laristizabal1/uPMU/uPMU_AFE/docs/uPMU_AFE_hoja2_mcu_gps.pdf

# uPMU prototipo Hoja 2/2: MCU, sincronización GPS y selector de país

NUCLEO-F303K8 (STM32F303K8T6, Cortex-M4F, 72 MHz) · GPS con PPS · los nombres de red (ADC_V, ADC_I, +3V3A) vienen de la hoja 1

## NUCLEO-F303K8

### STM32F303K8T6

TIM2 (32 bit, 72 MHz)
ARR = 1199 TRGO a 60 kHz
ADC1 + ADC2 simultáneos
DMA circular

TIM2_CH2: captura del PPS
(mismo contador que el ADC)

## PA0 / A0 (ADC1_IN1)

## ADC_V

## PA4 / A3 (ADC2_IN1)

## ADC_I

+3V3A

3V3

## GND

VDDA = 3V3 del Nucleo
(verificar filtrado en UM1956)

## Módulo GPS

NEO-6M / NEO-M8N
(GY-GPS6MV2)

ANT (SMA, antena activa
a la ventana)
PA1 / A1 (TIM2_CH2) | PPS

## PPS

PA10 / D0 (USART1_RX) | TX

## GPS_TX (NMEA)

PA9 / D1 (USART1_TX) | RX

## GPS_RX

3V3 | VCC
GND | GND

## +3V3 (GPS)

## GND

## PB0 / D3

SW3 50/60 Hz
abierto = 60 Hz (CO)
cerrado a GND = 50 Hz (CL) (pull-up interno)

## PB3 / D13

R_L 470

LD3 (en placa) | LED de estado (PPS válido)

## USB micro (ST-LINK VCP)

USART2 · PA2 / PA15

PC / ESP32-S3: tramas de fasores

## Plan de temporización (confirmar en RM0316)

- Reloj: HSE 8 MHz del MCO del ST-LINK PLL 72 MHz (el Nucleo-32 no trae cristal).
- Fs = 60 kS/s en 50 y 60 Hz ventana de 4 ciclos: 4000 muestras (60 Hz) o 4800 (50 Hz).
- Tiempo de muestreo del ADC 7,5 ciclos (Rs = 1 k ).

## Cadena de procesamiento (simulada, hoja 1 + este MCU)

1. Captura del PPS mide fase muestra-PPS y periodo real (corrige deriva del cristal).
2. CIC3, R = 4: 60 15 kS/s (retardo 4,5 muestras fijo).
3. IpDFT con ventana Hann + ajuste sinusoidal (Gauss-Newton) sobre 4 ciclos f, módulo y ángulo.
4. Compensa RC y CIC con el modelo; calibración de
1 punto por canal con carga resistiva.
5. Sin PPS: bandera «no sincronizado» (nunca válido).
