laristizabal1/uPMU/uPMU_AFE/docs/uPMU_AFE_hoja3_modelo_ltspice.pdf

## uPMU prototipo Hoja 3/3: el circuito que simula LTspice

Mismo circuito que los netlists de netlists/*.cir · valores = codigo/params.py · los elementos en gris son del MODELO: no se compran ni se sueldan

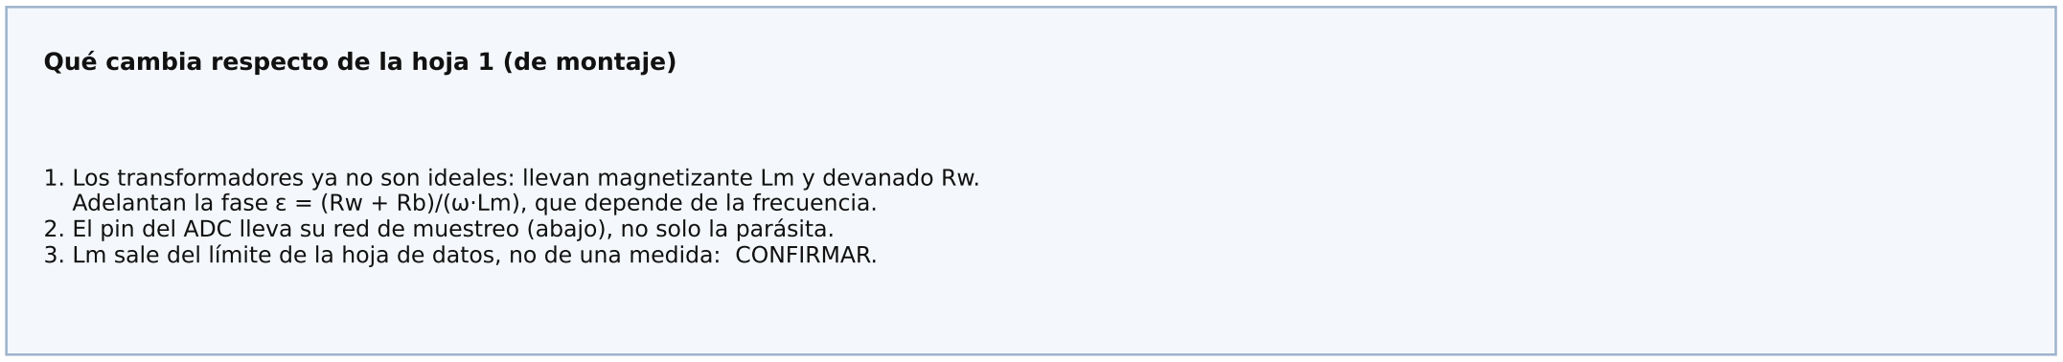
[picture p2: figure]

Qué cambia respecto de la hoja 1 (de montaje)

1. Los transformadores ya no son ideales: llevan magnetizante Lm y devanado Rw. Adelantan la fase = (Rw + Rb)/( ·Lm), que depende de la frecuencia.
2. El pin del ADC lleva su red de muestreo (abajo), no solo la parásita.
3. Lm sale del límite de la hoja de datos, no de una medida: CONFIRMAR.

Consecuencia medida en la simulación

Con el transformador ideal la fase V I daba 0,0000° exactos.
Con el modelo real: | 0.1733° a 50 Hz y | 0.1444° a 60 Hz.
La calibración de un punto la quita en f0, pero no fuera de f0:
a f0 ± 5 Hz el TVE pasa de ~0,01 % a 0,15 0,27 % (límite de la norma: 1 %).

Modelo del transformador

= (Rw + Rb) / ( ·Lm) [adelanto]

Lm NO se inventó: se derivó del error de fase de la hoja de datos.
ZMPT101B: | 20 con 100 | de carga
(aquí la carga es 470 | = 4,7×).
SCT-013: la hoja no lo publica;
se mantiene el supuesto de 1°.
50 Hz | 60 Hz
_V +0.827° | +0.689°
_I +1.000° | +0.833°
RC | -0.679° | -0.814°

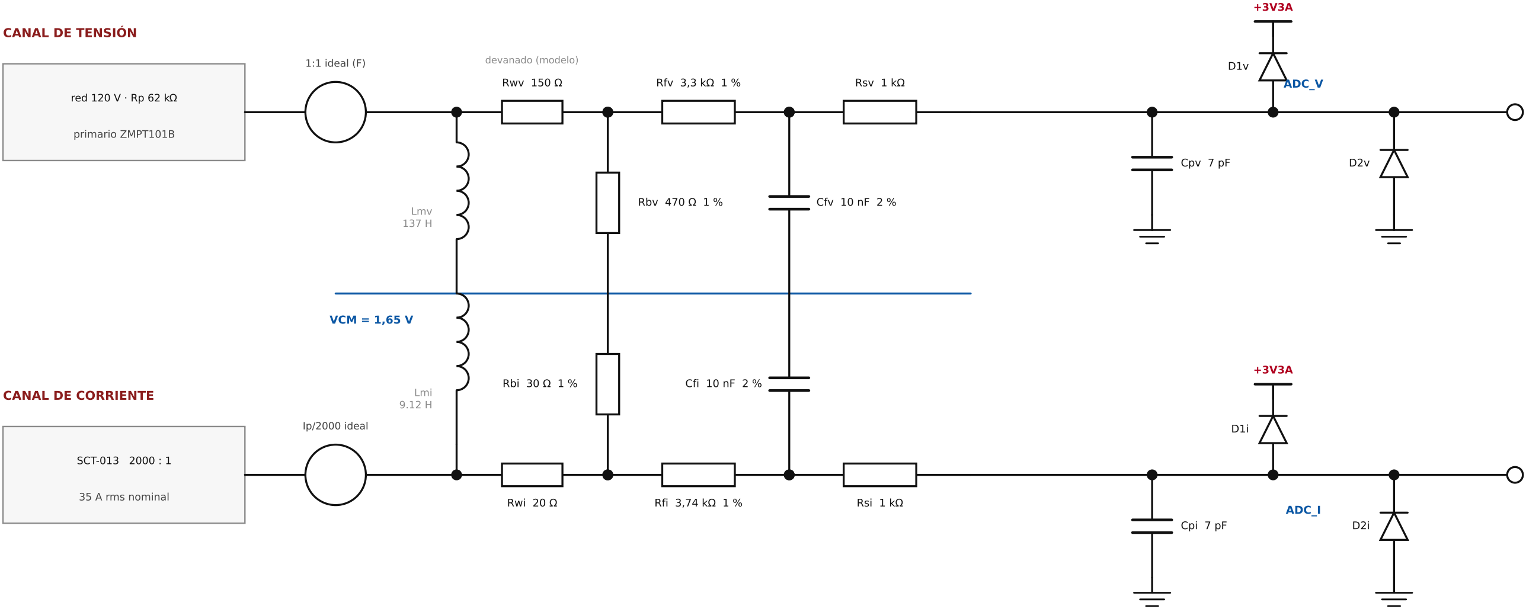
[picture p3: figure]
VCM = 1,65 V; CANAL DE TENSIÓN; red 120 V · Rp 62 k; primario ZMPT101B; 1:1 ideal (F); Lmv 137 H; Rwv 150; devanado (modelo); Rbv 470; Rfv 3,3 k; Cfv 10 nF 2 %; Rsv 1 k; ADC_V; Cpv 7 pF; CANAL DE CORRIENTE; SCT-013 2000 : 1; 35 A rms nominal; Ip/2000 ideal; Lmi 9.12 H; Rwi 20; Rbi 30; Rfi 3,74 k; Cfi 10 nF 2 %; Rsi 1 k; ADC_I; Cpi 7 pF

RED DE MUESTREO DEL ADC (modelo; está dentro del STM32F303K8)

pin ADC

C_par 7 pF
(pad + PCB)

muestreo: 4.10 µs
(61,5 ciclos a 15 MHz)

R_ADC 1 k CONFIRMAR

C_SH 5 pF
CONFIRMAR

¿Asientan 12 bits en la ventana de muestreo? Sí, con 46× de margen

= (Rsv + R_ADC) · C_SH = (1 k + 1 k ) · 5 pF = 10.0 ns
12 bits piden ln(2¹³)· = 90 ns; la ventana dura 4.10 µs margen 46×

Simulado con el interruptor real (netlists/uPMU_AFE_adcsh.cir), 60 ventanas: error entre C_SH y el pin al cerrar = 0.0028 LSB (canal V), 0.0017 LSB (canal I).

Ayuda que Cfv = 10 nF sea 2000× el condensador de muestreo: la carga que se redistribuye vale 5 pF / 10 nF = 5·10 de la diferencia entre muestras.

Hoja de simulación, no de montaje: Lm, Rw, R_ADC y C_SH son elementos del modelo. Para armar, usar la hoja 1/3. Los puntos CONFIRMAR están en docs/RESULTADOS_LTspice.pdf.
