laristizabal1/uPMU/STM32/uPMU/docs/nmea_delay.png

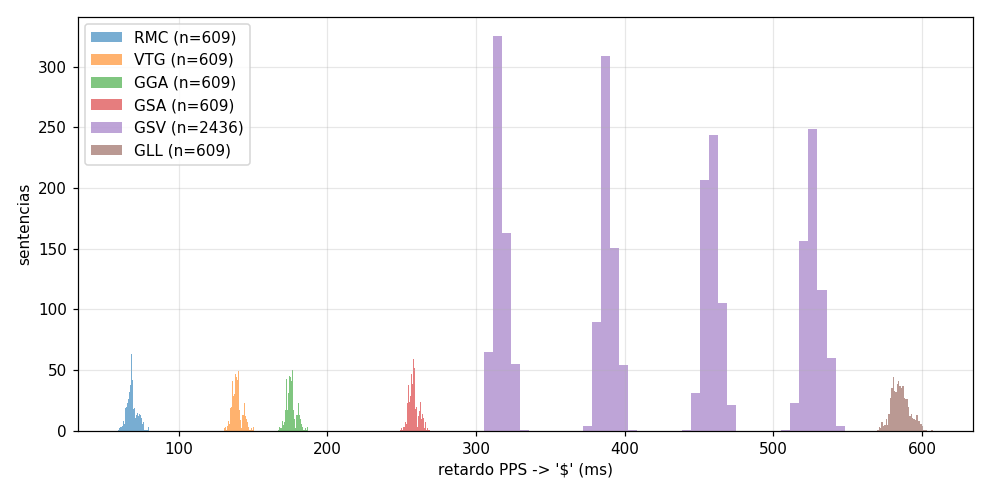
STM32/uPMU/docs/nmea_delay.png
