laristizabal1/uPMU/STM32/uPMU/docs/pps_6min.png

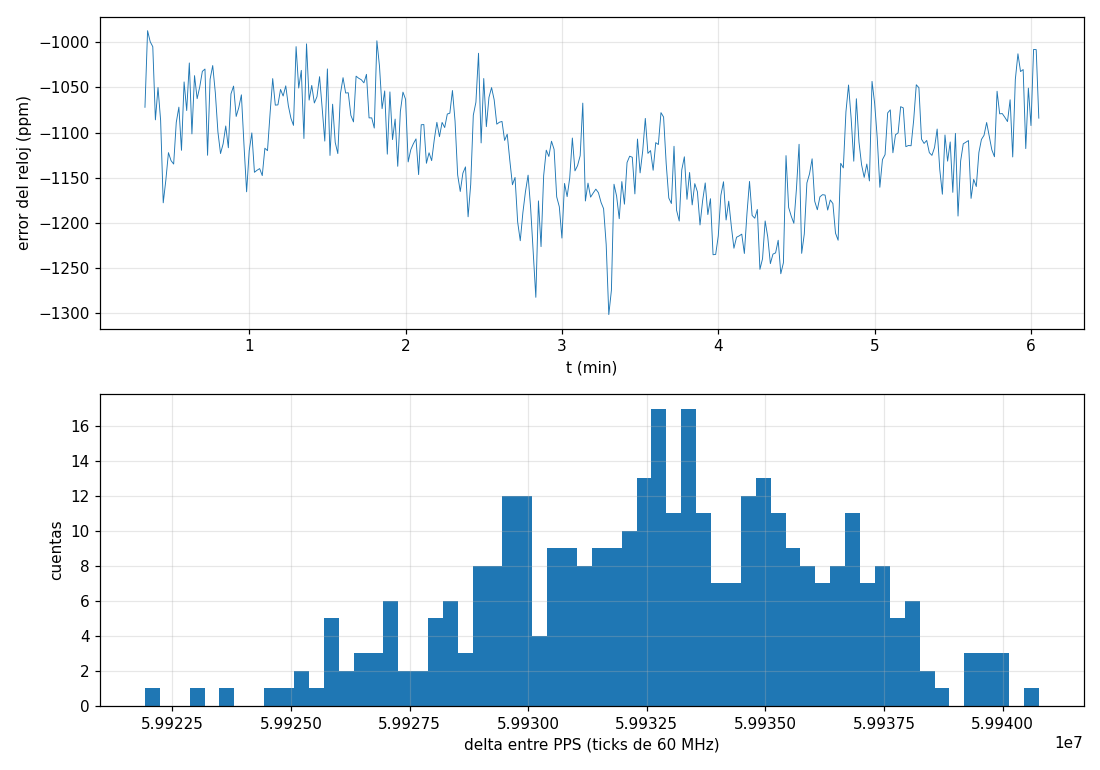
STM32/uPMU/docs/pps_6min.png
