laristizabal1/uPMU/STM32/uPMU/docs/pps_30min.png

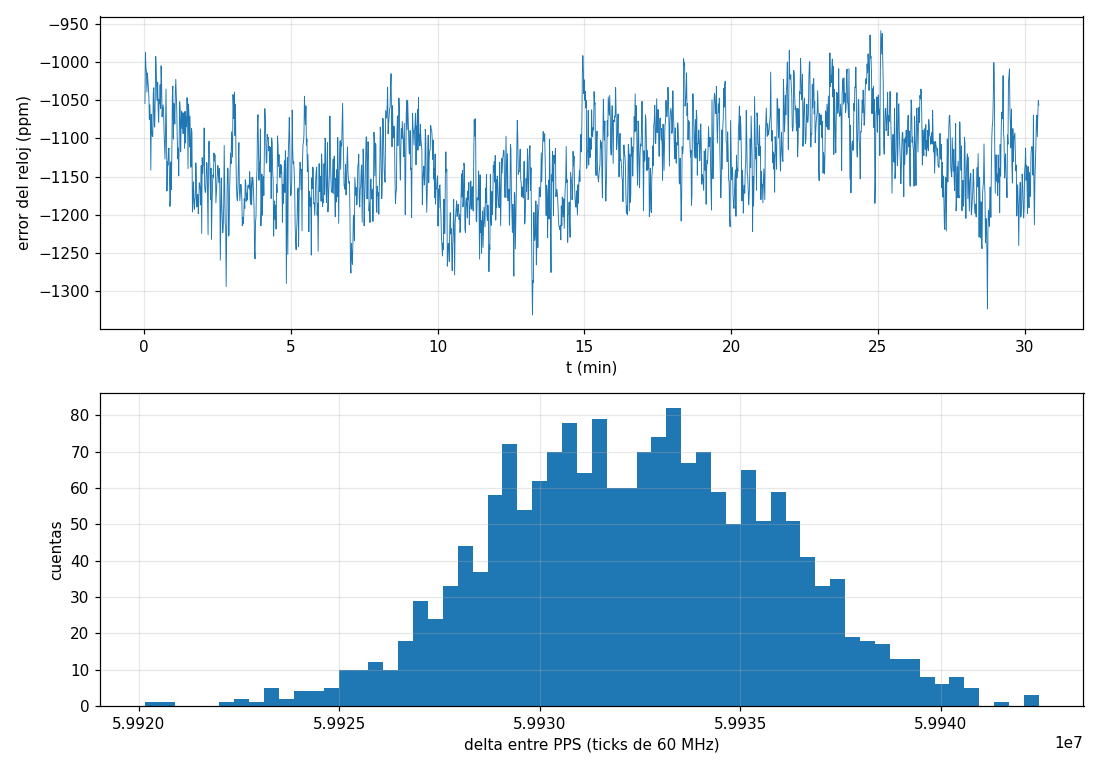
STM32/uPMU/docs/pps_30min.png
