laristizabal1/uPMU/STM32/uPMU/docs/stamp.png

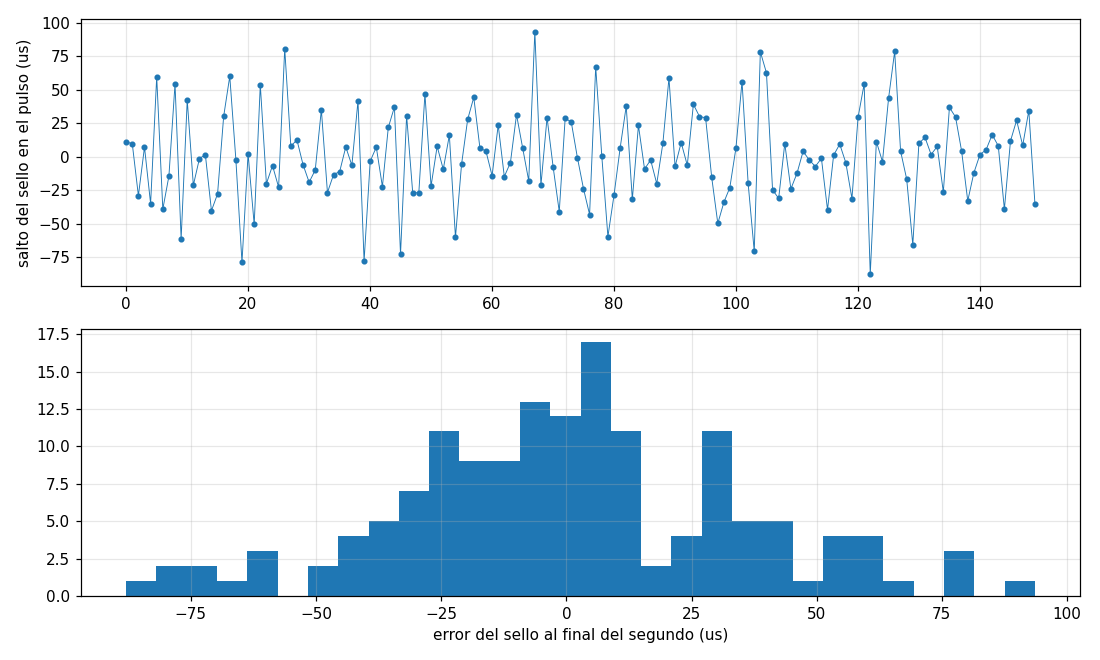
STM32/uPMU/docs/stamp.png
