laristizabal1/uPMU/STM32/uPMU/docs/viewer_5min.png

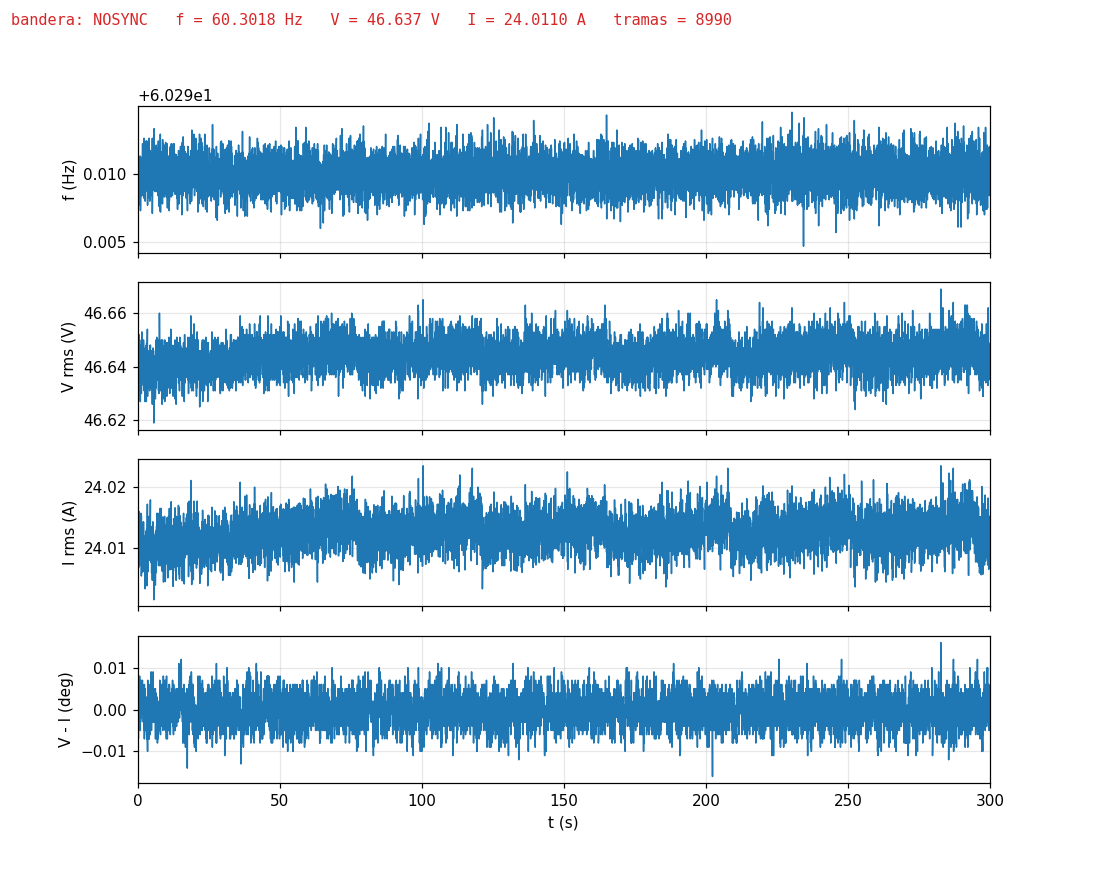
STM32/uPMU/docs/viewer_5min.png
