laristizabal1/uPMU/STM32/uPMU/docs/viewer_replay.png

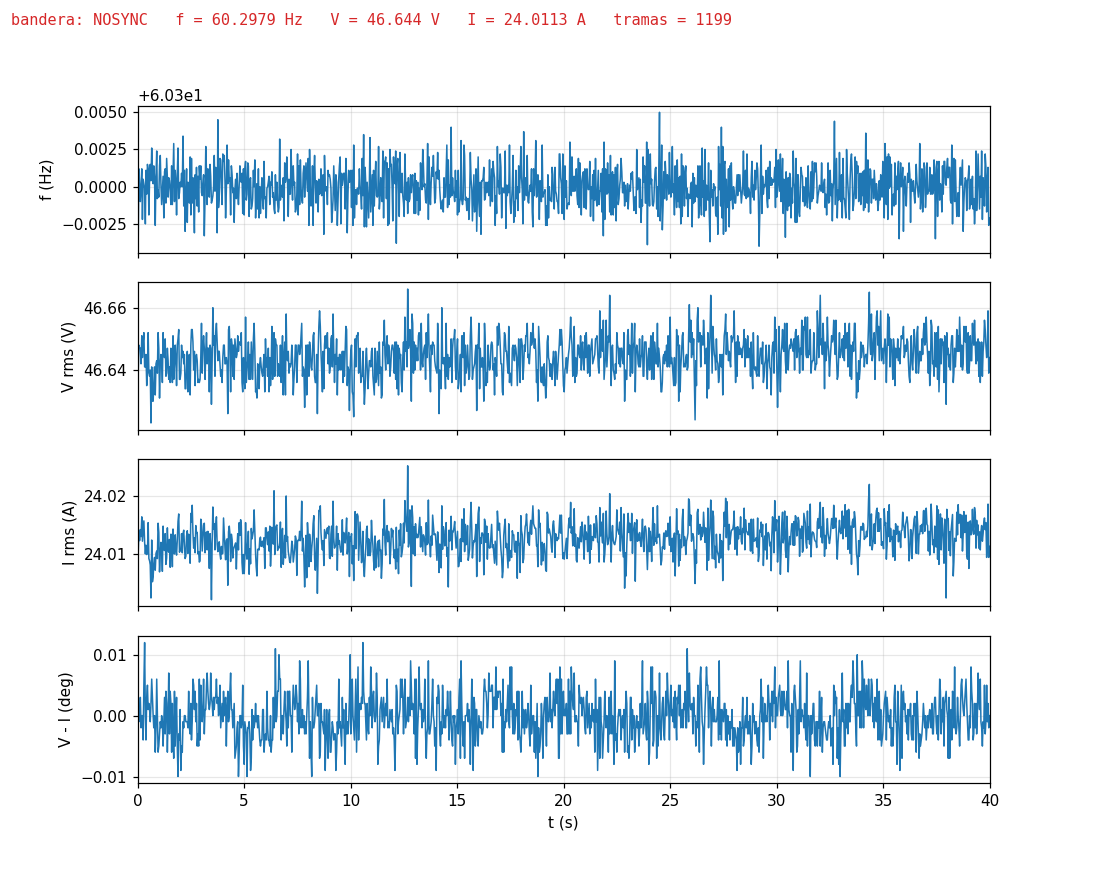
STM32/uPMU/docs/viewer_replay.png
