laristizabal1/uPMU/uPMU_AFE/figuras/ltspice_ac.png

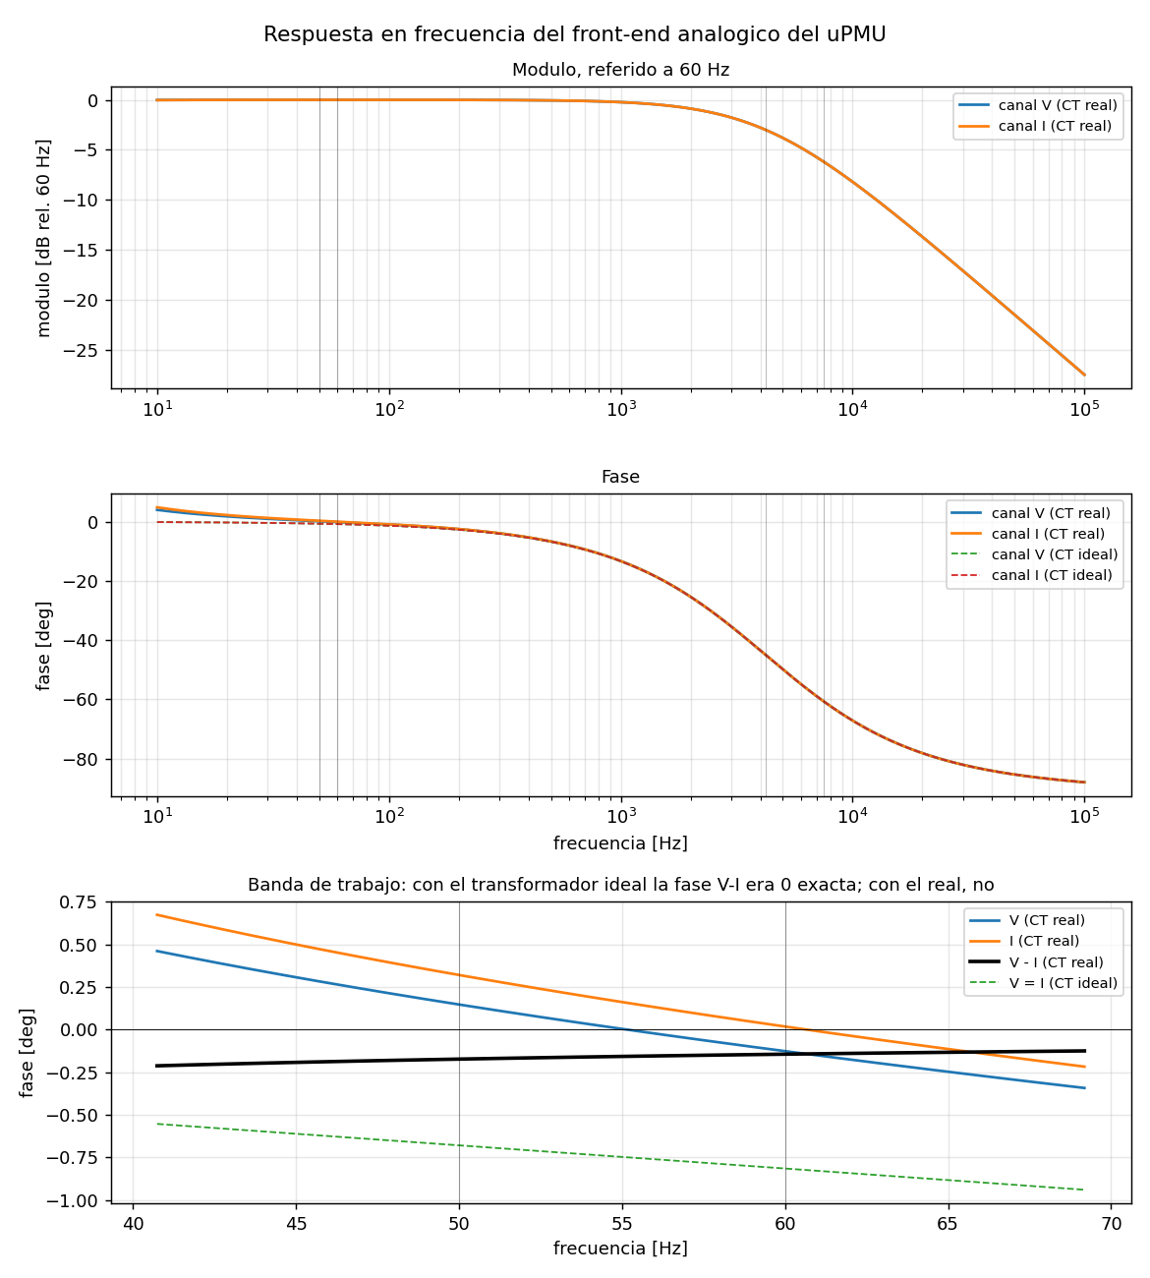
uPMU_AFE/figuras/ltspice_ac.png
