laristizabal1/uPMU/uPMU_AFE/figuras/ltspice_montecarlo.png

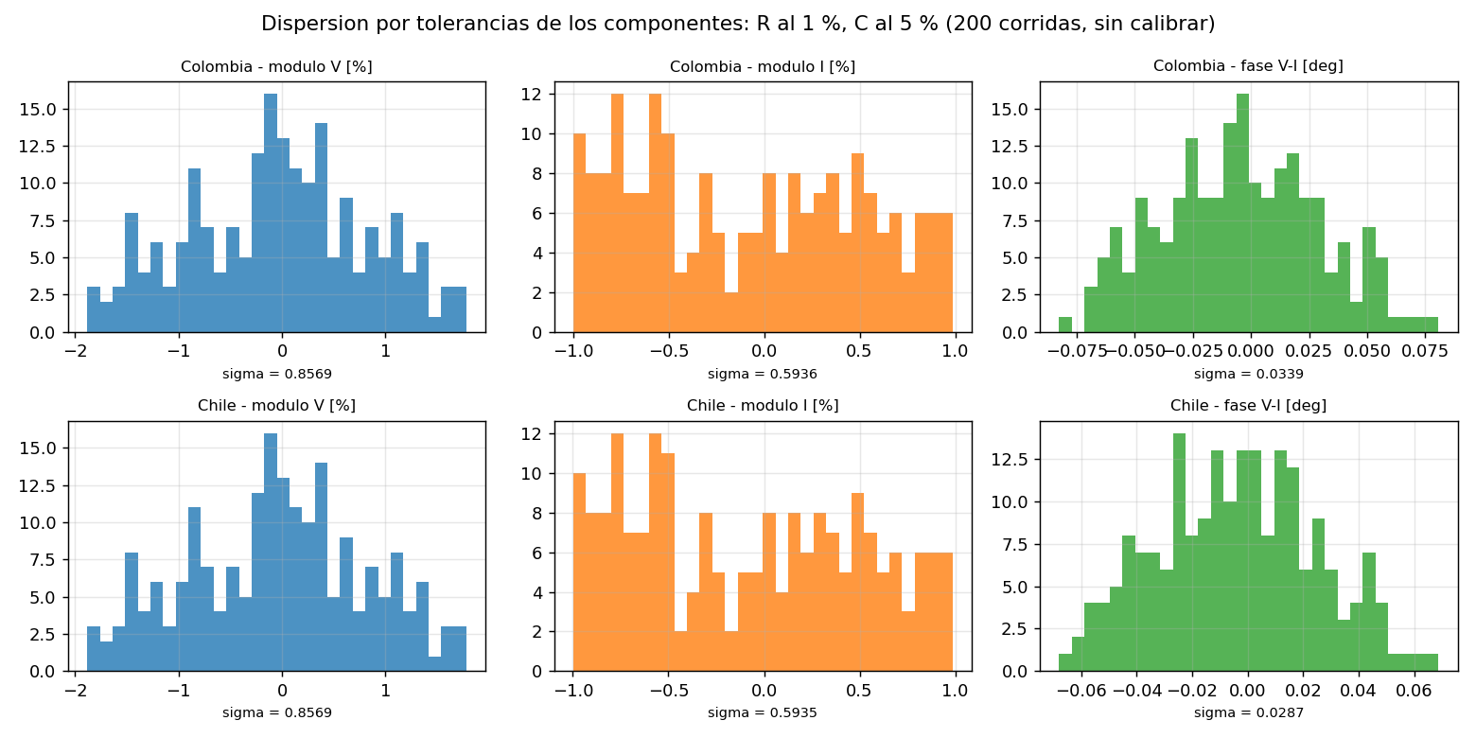
uPMU_AFE/figuras/ltspice_montecarlo.png
