laristizabal1/uPMU/uPMU_AFE/figuras/ltspice_tran.png

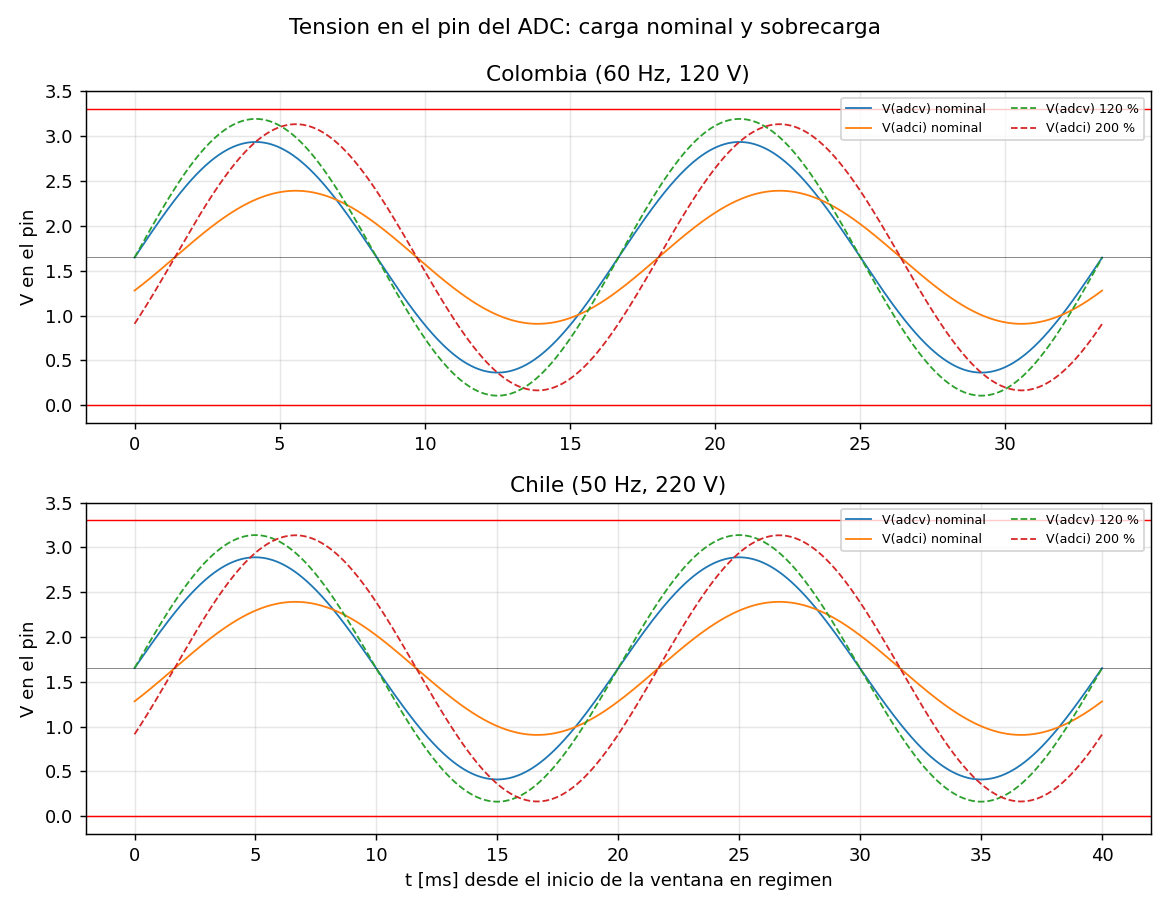
uPMU_AFE/figuras/ltspice_tran.png
