laristizabal1/uPMU/uPMU_AFE/figuras/uPMU_AFE_hoja1_analogico.png

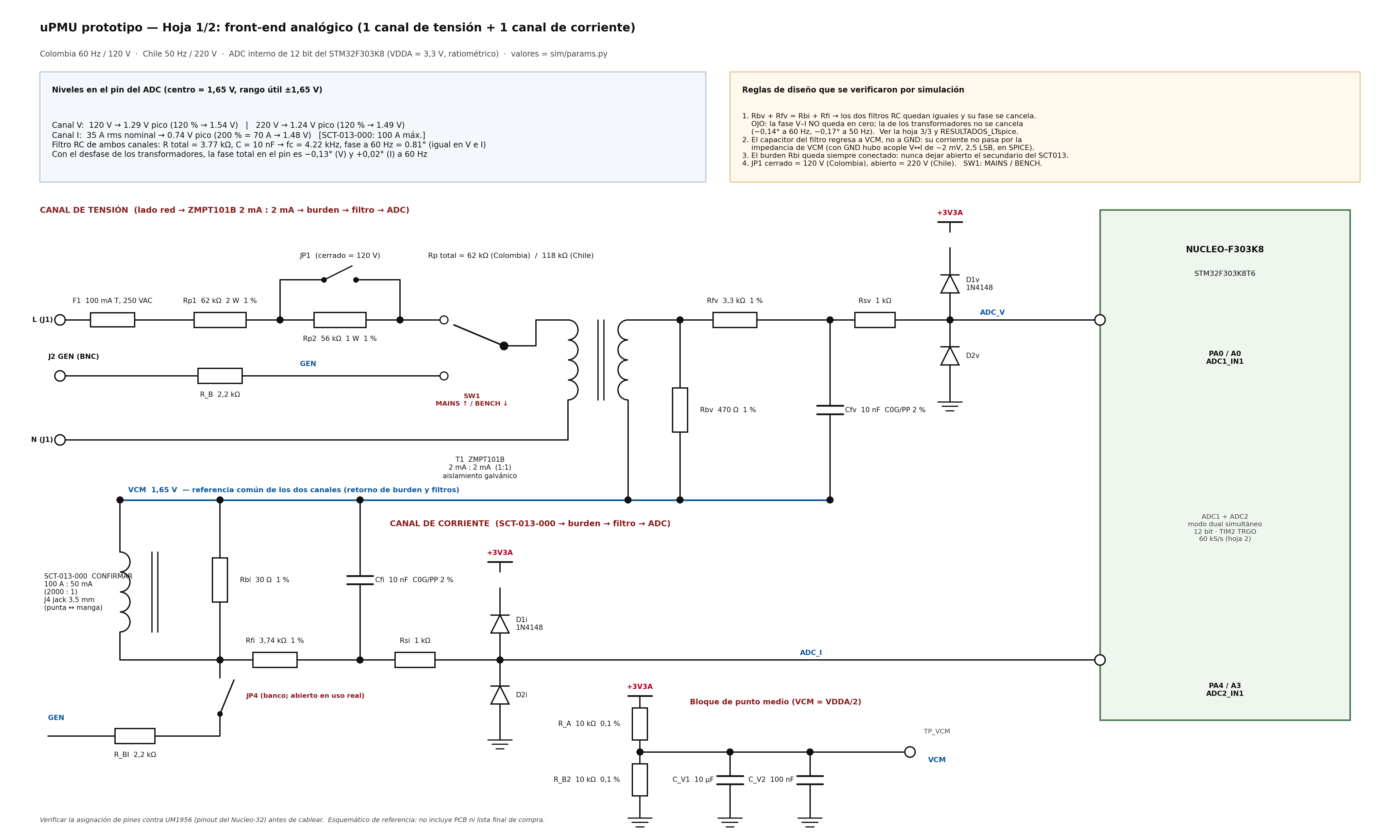
uPMU_AFE/figuras/uPMU_AFE_hoja1_analogico.png
