laristizabal1/uPMU/uPMU_AFE/figuras/uPMU_AFE_hoja2_mcu_gps.png

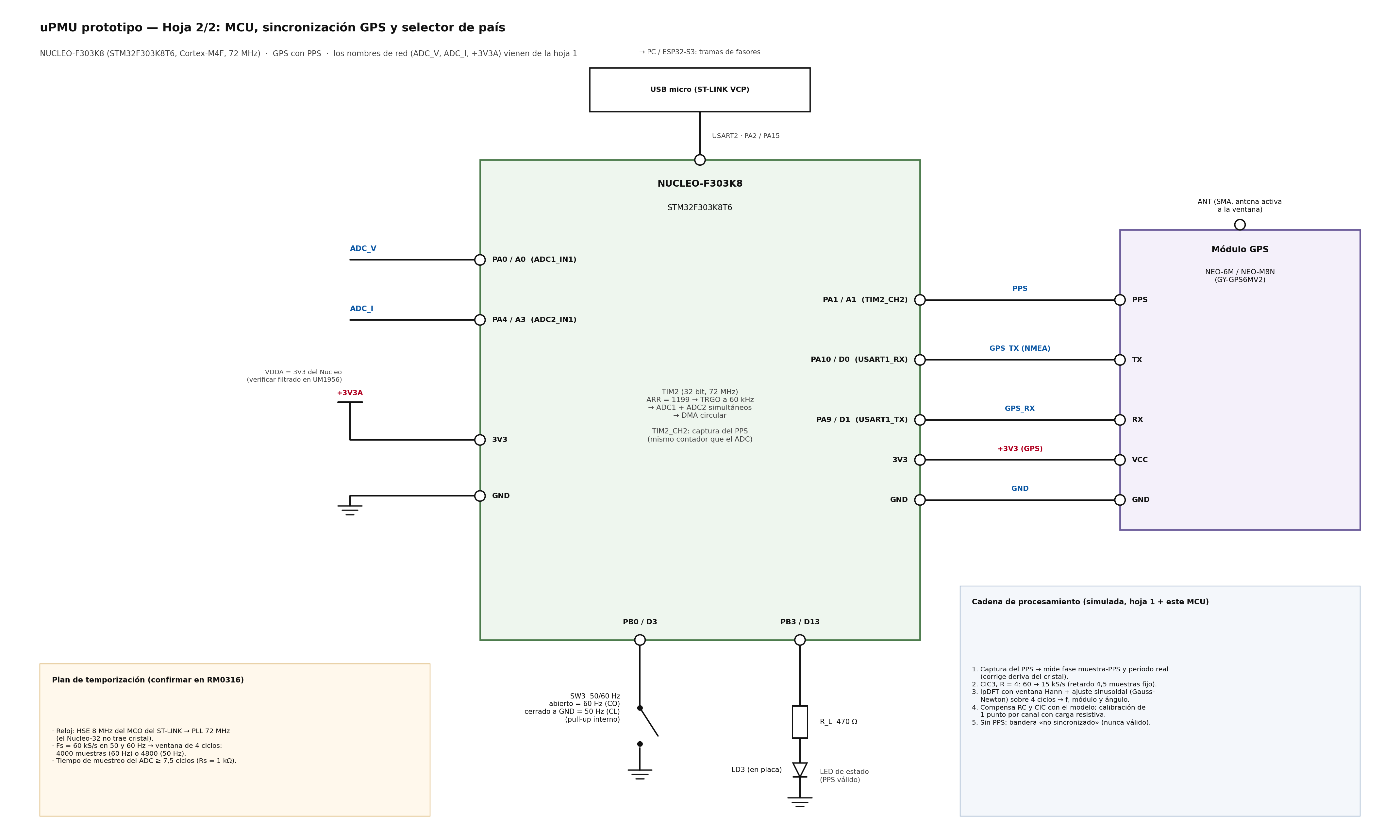
uPMU_AFE/figuras/uPMU_AFE_hoja2_mcu_gps.png
