laristizabal1/uPMU/uPMU_AFE/figuras/uPMU_AFE_hoja3_modelo_ltspice.png

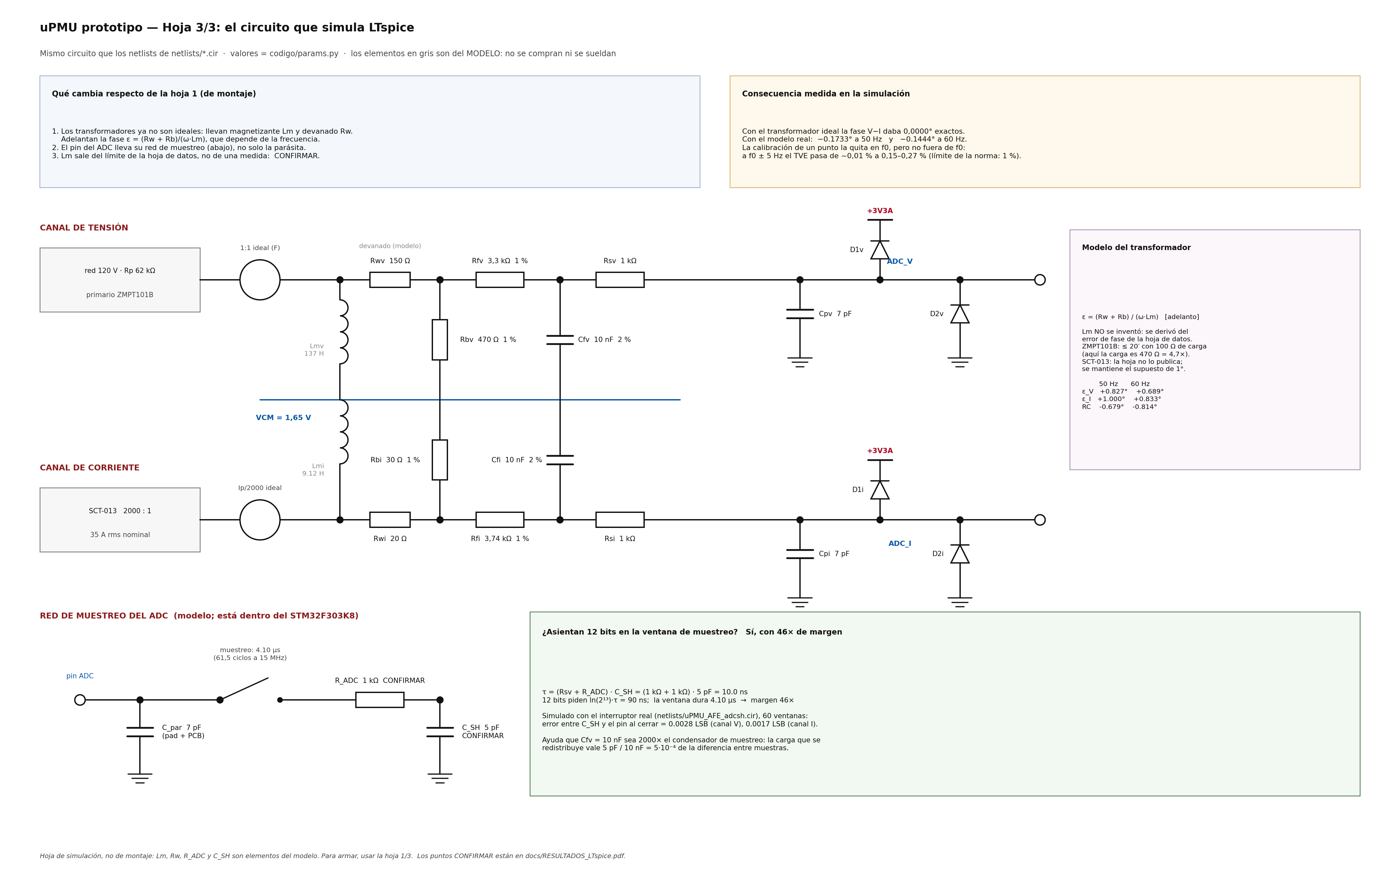
uPMU_AFE/figuras/uPMU_AFE_hoja3_modelo_ltspice.png
