laristizabal1/uPMU/STM32/uPMU/data/t5_dac_test_20261011.csv

2026-10-11T02:58:23.184208 | PMU,,73.9155,0.006,-125.182,0.0055,-62.340,NOSYNC
2026-10-11T02:58:23.193225 | PMU,,50.4883,0PMU,,60.2408,2.829,136.172,24.0120,115.209,NOSYNC
2026-10-11T02:58:23.223190 | PMU,,60.0486,2.838,137.974,24.0068,118.803,NOSYNC
2026-10-11T02:58:23.258274 | PMU,,60.0945,2.784,138.377,24.0126,122.415,NOSYNC
2026-10-11T02:58:23.291560 | PMU,,60.2215,2.796,139.538,24.0112,126.003,NOSYNC
2026-10-11T02:58:23.326184 | PMU,,60.1505,2.838,139.987,24.0116,129.602,NOSYNC
2026-10-11T02:58:23.359892 | PMU,,60.1941,2.806,142.847,24.0069,133.215,NOSYNC
2026-10-11T02:58:23.394235 | PMU,,60.0476,2.823,144.168,24.0136,136.812,NOSYNC
2026-10-11T02:58:23.424353 | PMU,,60.1162,2.845,144.838,24.0108,140.405,NOSYNC
2026-10-11T02:58:23.458186 | PMU,,60.2395,2.823,145.838,24.0096,144.009,NOSYNC
2026-10-11T02:58:23.492286 | PMU,,60.2259,2.806,147.784,24.0110,147.608,NOSYNC
2026-10-11T02:58:23.526912 | PMU,,60.0417,2.811,149.021,24.0086,151.202,NOSYNC
2026-10-11T02:58:23.561254 | PMU,,60.1873,2.791,149.543,24.0117,154.808,NOSYNC
2026-10-11T02:58:23.590711 | PMU,,60.0625,2.850,150.882,24.0078,158.415,NOSYNC
2026-10-11T02:58:23.625254 | PMU,,60.2211,2.785,152.787,24.0082,162.011,NOSYNC
2026-10-11T02:58:23.659463 | PMU,,60.1991,2.829,155.048,24.0106,165.608,NOSYNC
2026-10-11T02:58:23.693131 | PMU,,60.1065,2.790,155.034,24.0085,169.205,NOSYNC
2026-10-11T02:58:23.700969 | ADC,2,179968,60160,0,0,0,148.4/34/237/36.53,2047.8/1411/2686/446.88
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
2026-10-11T02:58:53.123983 | PMU,,60.0407,2.334,165.491,24.0136,104.388,NOSYNC
2026-10-11T02:58:53.158127 | PMU,,60.1354,2.363,166.528,24.0108,107.991,NOSYNC
2026-10-11T02:58:53.160127 | STATE,111026T075853.00,0,0
2026-10-11T02:58:53.191928 | PMU,,60.1641,2.362,168.614,24.0146,111.590,NOSYNC
