laristizabal1/uPMU/uPMU_AFE/netlists/uPMU_AFE.asc

Cfi: cap; 1e-08
Cfv: cap; 1e-08
Cpi: cap; 7e-12
Cpv: cap; 7e-12
Cvcm1: cap; 1e-05
Cvcm2: cap; 1e-07
D1i: diode; D1N4148
D1v: diode; D1N4148
D2i: diode; D1N4148
D2v: diode; D1N4148
Fv: f; Vsp 1
Ict: current; SIN(0 0.0247487 60 0 0 -30); AC 0.0175
Lmi: ind; 9.11891
Lmv: ind; 136.784
Rbi: res; 30
Rbv: res; 470
Rfi: res; 3740
Rfv: res; 3300
Rp: res; 62000
Rsi: res; 1000
Rsv: res; 1000
Rvcm1: res; 10000
Rvcm2: res; 10000
Rwi: res; 20
Rwv: res; 150
Vdda: voltage; 3.3
Vmains: voltage; SIN(0 169.706 60 0 0 0); AC 120
Vsp: voltage; 0
Named nets: 0, nL, np, vcm, nsv, bv, nv, adcv, vdda, nsi, bi, ni, adci
.model D1N4148 D(Is=4.352n N=1.906 Rs=.6458 Ikf=44.17m Xti=3 Eg=1.11 Cjo=4p M=.3333 Vj=.5 Fc=.5 Isr=1.21n Nr=2 Bv=110 Ibv=1u Tt=11.54n)
.options reltol=1e-6 vntol=1e-9 abstol=1e-12
.tran 2u 5.1 5 2u
uPMU AFE - Colombia (60 Hz). Generado por codigo/make_asc.py desde params.py.
OJO: el .tran simula 5 s y guarda los ultimos 100 ms. El magnetizante de los transformadores tarda segundos en asentarse (ver docs/RESULTADOS_LTspice.pdf).
