laristizabal1/uPMU/(commit log)

2026-10-12 Reorganiza el repositorio: proyecto PlatformIO en STM32/uPMU y .gitignore raiz
    El esqueleto de PlatformIO pasa de la raiz a STM32/uPMU para convivir con
    uPMU_AFE (front-end y simulacion). El .gitignore raiz deja fuera node_modules,
    las salidas regenerables de LTspice/ngspice y los PDF de terceros (Paper/).
2026-10-12 Firmware: reloj, GPS, ADC dual, CIC, estimador y cadena en vivo
    NUCLEO-F303K8. Reloj HSI/2 x PLL15 = 60 MHz (HSE opcional con -DUSE_HSE y respaldo a HSI), USART1 con NMEA y parser, TIM2 a 60 kS/s disparando ADC1+ADC2 en modo dual con DMA, captura del PPS en TIM2_CH2 con contador de disparos por hardware (TIM3), CIC de orden 3 R=4 entero, IpDFT + minimos cuadrados con FPU, ventana circular, sello UTC, maquina de estados SYNC/HOLD/NOSYNC y trama PMU. fpu.py agrega las banderas de FPU al enlazado.
2026-10-12 Herramientas y pruebas en la PC
    Registro serie, envio de vectores de prueba, generacion de vectores desde ref/, analisis del PPS y del retardo NMEA, comprobacion del sello, verificacion de TVE del firmware contra la simulacion, visor en vivo y pruebas del mismo C del firmware compilado en la PC (parser NMEA, receptor de vectores, estimador, pipeline).
2026-10-12 ref: copia de solo lectura de la simulacion de referencia (uPMU_AFE/sim)
    Parametros y cadena completa (red, sensor, burden, filtro, ADC, CIC, IpDFT + minimos cuadrados) usada como verdad para los vectores de prueba.
2026-10-12 Datos: vectores de prueba y logs crudos de medicion
    data/vectors: 14 vectores (2 redes x 7 escenarios) con codigos del ADC y salida esperada. Resto: logs con marca de tiempo de la PC de cada tarea (reloj, GPS, PPS, ADC, ruido, estimador, sello).
    [t1_2_clk_20261010.csv, t1_2_hse_probe_20261010.csv, t1_3_gps_boot_20261010.csv, t1_3_gps_nmea_20261010.csv, t1_4_state_20261010.csv, t1_5_antena2_20261011.csv, t1_5_antena_20261011.csv, t1_5_fix_20261010.csv]
2026-10-12 Docs: resultados medidos y formato de la trama
    RESULTADOS.md con las cifras de cada tarea (fecha, log, condiciones) y FORMATO_TRAMA.md con la especificacion de la linea PMU, banderas y cadencia.
2026-10-12 uPMU_AFE: front-end analogico, esquematicos y simulacion
    Esquematicos (hoja analogica y MCU+GPS), netlists SPICE/LTspice, modelo y simulacion de la cadena completa, resultados y README. Se excluyen las salidas regenerables (.raw, .db, ng_*/out_*.json) y node_modules.
2026-10-12 README raiz y .gitattributes
    Descripcion del proyecto, estructura del repositorio, estado medido, limitacion abierta del reloj y uso rapido. .gitattributes normaliza los finales de linea a LF.
2026-10-12 uPMU_AFE: simulacion en LTspice, modelo del transformador y reorganizacion
    Simulacion
    - Se corre todo en LTspice 26.0.2 en modo batch (-b). Se retira el camino
    alterno por ngspice, que era el plan B mientras no hubiera LTspice.
    - Contraste independiente con un modelo cerrado exacto en Python
    (codigo/afe_model.py): coinciden a 0,0003 % en modulo y 0,0005 grados en
    fase a 50/60 Hz, y a 0,016 mV (0,020 LSB) muestra a muestra en el
    transitorio.
    Correcciones de modelado
    - .ac excitaba los dos canales a la vez y con AC 1 = 1 A en el secundario
    del CT (2000 A primarios): contaminaba el canal V un 0,39 % en modulo.
    Ahora cada canal se excita por separado y con su unidad fisica.
    - Los tr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
2026-10-12 README: diagrama de bloques de la cadena de medicion
    Reemplaza el esquema en texto plano por una figura generada desde
    codigo/params.py (codigo/draw_cadena.py), con la convencion habitual de
    un diagrama de bloques: cada bloque es un componente y cada flecha lleva
    la senal que lo recorre, con su magnitud y unidad.
    Cubre las tres partes de la cadena: el front-end analogico de los dos
    canales (de la red y del lazo de corriente hasta el pin del ADC), el
    procesamiento dentro del microcontrolador (ADC, CIC, ventana, estimador y
    trama) y la rama de sincronizacion por PPS y NMEA.
    Al salir de params.py, las cifras no se desacoplan de la simulacion.
